PepperCat-YamanekoVillage/ESP32C3_USBSWITCHHUB/README.md

LICENSE -> https://creativecommons.org/licenses/by-nc-sa/4.0/
