PepperCat-YamanekoVillage/ESP32C3_USBSWITCHHUB/case/case.3mf

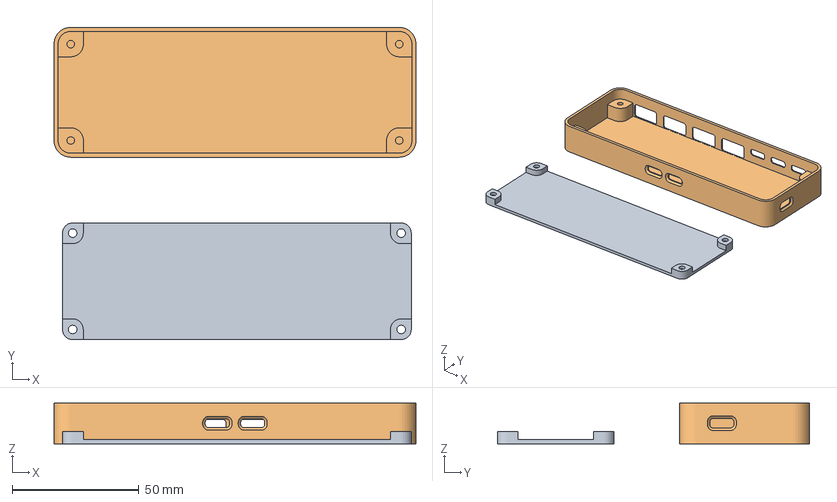
[picture p1: CAD file, 2025-08-16]
case/case.3mf
142.7 x 123.1 x 16.0 mm
lower.stl
upper.stl
