PepperCat-YamanekoVillage/ESP32C3_USBSWITCHHUB/case/upper.stl

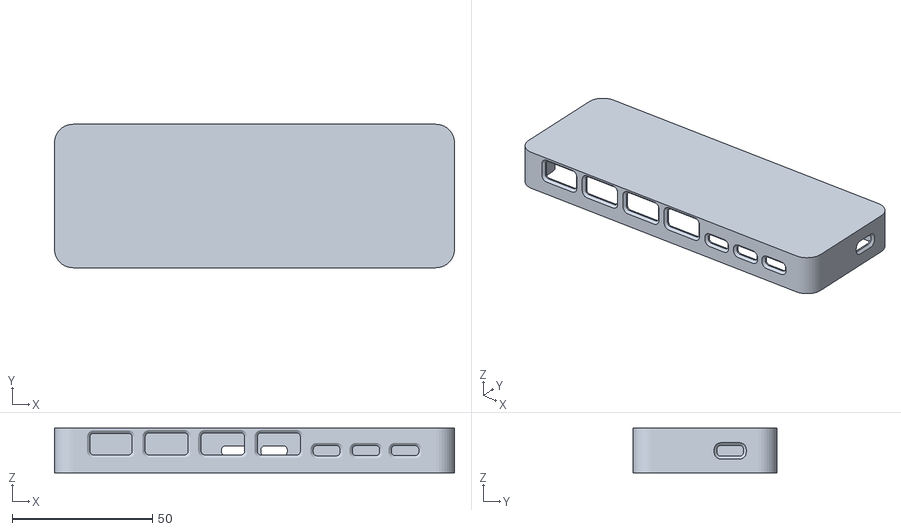
[picture p2: CAD file, 2025-08-16]
case/upper.stl
142.7 x 51.2 x 16.0
