PepperCat-YamanekoVillage/ESP32C3_USBSWITCHHUB/case/lower.stl

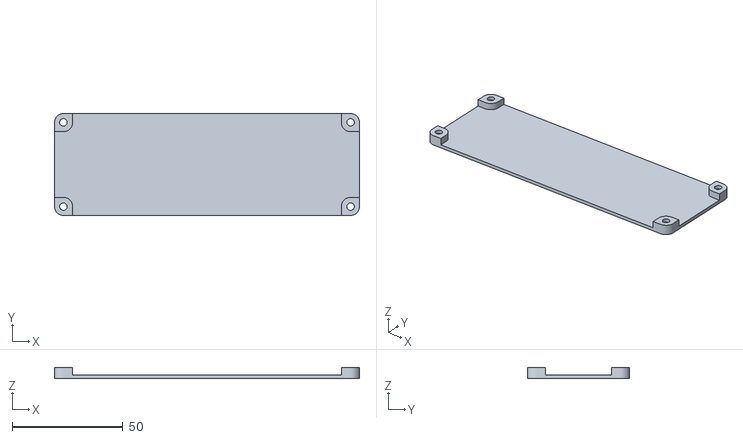
[picture p3: CAD file, 2025-08-16]
case/lower.stl
137.5 x 46.0 x 4.85
