PepperCat-YamanekoVillage/ESP32C3_USBSWITCHHUB/pcb/usbhub_rev.kicad_pcb

## KiCad design pcb/usbhub_rev.kicad_pcb (2025-08-16)

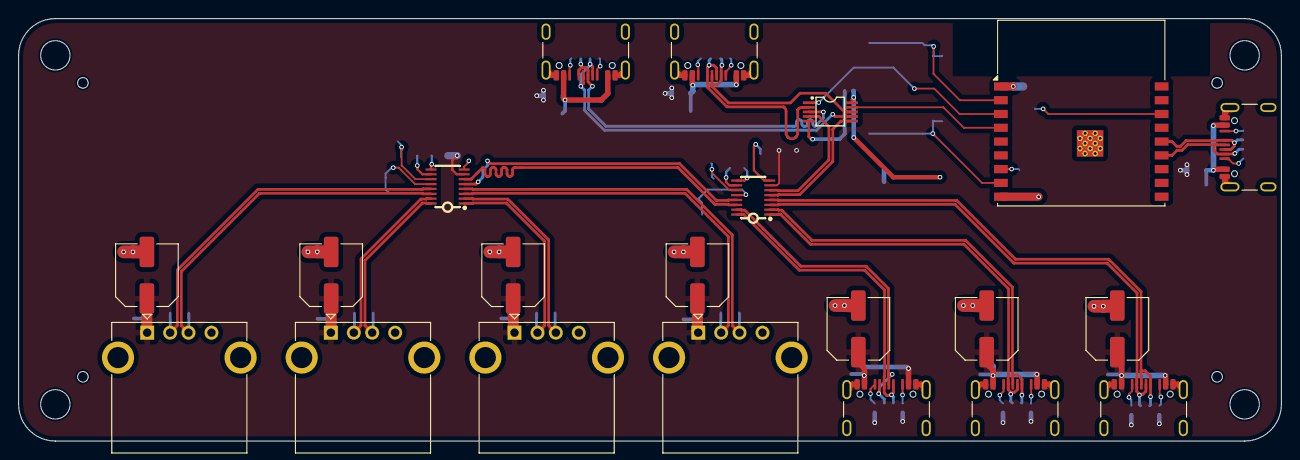
[picture p4: board usbhub_rev.kicad_pcb from above]

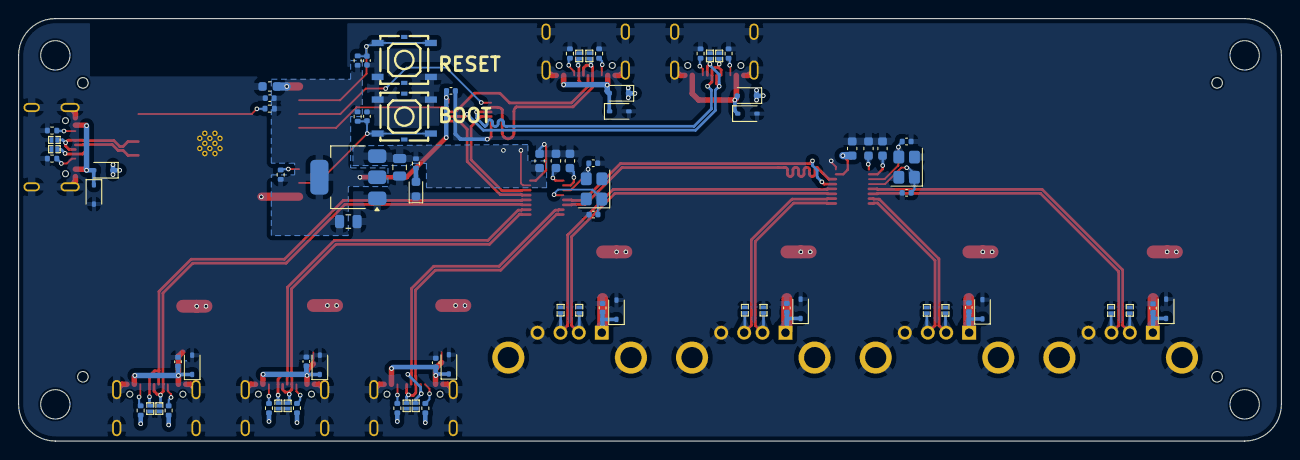
[picture p5: board usbhub_rev.kicad_pcb from below]

Board: 2 copper layers, 137.5 x 46.0 mm, 109 parts (80 on the bottom side), 57 nets.

Parts:
C1, C2, C7, C8, C9, C11, C12: 10uF; C_0603_1608Metric
C3, C17, C18, C20, C21, C23, C24: 100uF; C_Elec_6.3x5.4
C4, C19, C22, C25, C26, C27, C28, C29, C30, C31: 100nF; C_0402_1005Metric
C5, C6, C13, C15: 20pF; C_0402_1005Metric
C10, C14: 22uF; C_0805_2012Metric
C16: 12pF; C_0402_1005Metric
D1: LED; LED_0603_1608Metric
D2, D4, D5, D7, D8, D13, D14, D16, D17, D18, D20, D22, D23, D24, D26, D27, D29, D30, D32, D33: ESD/S3.3VmSp; DFN1006-2L_L1.0-W0.6-P0.60-BI
D3, D9, D11, D15, D19, D21, D25, D28, D31, D34: ESD/PW5V; D_SOD-323
D6, D10, D12: BAT/10V; D_SOD-323
H1, H2, H3, H4: MountingHole_3.2mm_M3_ISO7380
H5, H6, H7, H8: toolinghole
J1, J2, J3, J5, J6, J7: USB_C_Connecter; usbc_reflow
J4, J8, J9, J10: USB_A; USB_A_Kycon_KUSBX-AS1N-B_Horizontal
R1, R2, R23, R25: 10k; R_0402_1005Metric
R3, R4, R5, R6, R20, R21: 5.1k; R_0402_1005Metric
R7, R8, R9, R10, R11, R12: 56k; R_0402_1005Metric
R13: 2k; R_0402_1005Metric
SW2, SW3: SW_Push; SW-SMD_6P-L5.2-W5.2-P3.70-LS6.4
U1: ESP32-C3-WROOM-02
U2: TS3USB30EDGSR; VSSOP-10_L3.0-W3.0-P0.50-LS4.9-BL
U3, U5: SL2.1S; SSOP-16_L4.6-W2.6-P0.53-LS4.0-BL
U4: AMS1117-3.3; SOT-223-3_TabPin2
Y1, Y2: 12MHz; Crystal_SMD_3225-4Pin_3.2x2.5mm

Connections:
+3.3V: C1.2, C4.2, C14.1, C19.2, R1.1, R2.1, R23.2, R25.2, U1.1 (3V3), U2.10 (VCC), U4.2 (VO)
+5V: C2.1, C3.1, C7.1, C10.1, C17.1, C18.1, C20.1, C21.1, C23.1, C24.1, C25.2, C26.2, C27.2, C28.2, C29.2, C30.2, C31.2, D6.1 (K), D10.1 (K), D12.1 (K), D15.1 (A1), D19.1 (A1), D21.1 (A1), D25.1 (A1), D28.1 (A1), D31.1 (A1), D34.1 (A1), J4.1 (VBUS), J5.A4 (VBUS), J5.B9 (VBUS), J6.A4 (VBUS), J6.B9 (VBUS), J7.A4 (VBUS), J7.B9 (VBUS), J8.1 (VBUS), J9.1 (VBUS), J10.1 (VBUS), R7.2, R8.2, R9.2, R10.2, R11.2, R12.2, R13.1, U3.7 (VDD5), U4.3 (VI), U5.7 (VDD5)
/SELECT: U1.3 (IO4), U2.1 (S)
/deviceA1/D+: D26.2 (A2), J8.3 (D+), U5.2 (DP2)
/deviceA1/D-: D27.2 (A2), J8.2 (D-), U5.1 (DM2)
/deviceA2/D+: D29.2 (A2), J9.3 (D+), U5.16 (DP3)
/deviceA2/D-: D30.2 (A2), J9.2 (D-), U5.15 (DM3)
/deviceA3/D+: D32.2 (A2), J10.3 (D+), U5.14 (DP4)
/deviceA3/D-: D33.2 (A2), J10.2 (D-), U5.13 (DM4)
/deviceA/D+: D14.2 (A2), J4.3 (D+), U5.4 (DP1)
/deviceA/D-: D16.2 (A2), J4.2 (D-), U5.3 (DM1)
/deviceC1/D+: D17.2 (A2), J5.A6 (D+), J5.B6 (D+), U3.2 (DP2)
/deviceC1/D-: D18.2 (A2), J5.A7 (D-), J5.B7 (D-), U3.1 (DM2)
/deviceC2/D+: D22.2 (A2), J7.A6 (D+), J7.B6 (D+), U3.16 (DP3)
/deviceC2/D-: D24.2 (A2), J7.A7 (D-), J7.B7 (D-), U3.15 (DM3)
/deviceC/D+: D20.2 (A2), J6.A6 (D+), J6.B6 (D+), U3.4 (DP1)
/deviceC/D-: D23.2 (A2), J6.A7 (D-), J6.B7 (D-), U3.3 (DM1)
/esp32c3/BOOT: C16.2, R23.1, SW2.2, U1.8 (IO9)
/esp32c3/RESET: C22.2, R25.1, SW3.2, U1.2 (EN)
/esp32c3/USB_D+: D4.2 (A2), J1.A6 (D+), J1.B6 (D+), U1.14 (IO19)
/esp32c3/USB_D-: D5.2 (A2), J1.A7 (D-), J1.B7 (D-), U1.13 (IO18)
/host1/USB_D+: D8.2 (A2), J3.A6 (D+), J3.B6 (D+), U2.3 (D2+)
/host1/USB_D-: D13.2 (A2), J3.A7 (D-), J3.B7 (D-), U2.7 (D2-)
/host/USB_D+: D2.2 (A2), J2.A6 (D+), J2.B6 (D+), U2.2 (D1+)
/host/USB_D-: D7.2 (A2), J2.A7 (D-), J2.B7 (D-), U2.8 (D1-)
/hub/D+: U2.4 (D+), U3.6 (UDP)
/hub/D-: U2.6 (D-), U3.5 (UDM)
/hub/D_CHILD_D+: U3.14 (DP4), U5.6 (UDP)
/hub/D_CHILD_D-: U3.13 (DM4), U5.5 (UDM)
/~OE: U1.4 (IO5), U2.9 (~OE)
GND: C1.1, C2.2, C3.2, C4.1, C5.2, C6.1, C7.2, C8.1, C9.1, C10.2, C11.1, C12.1, C13.2, C14.2, C15.1, C16.1, C17.2, C18.2, C19.1, C20.2, C21.2, C22.1, C23.2, C24.2, C25.1, C26.1, C27.1, C28.1, C29.1, C30.1, C31.1, D1.1 (K), D2.1 (A1), D3.2 (A2), D4.1 (A1), D5.1 (A1), D7.1 (A1), D8.1 (A1), D9.2 (A2), D11.2 (A2), D13.1 (A1), D14.1 (A1), D15.2 (A2), D16.1 (A1), D17.1 (A1), D18.1 (A1), D19.2 (A2), D20.1 (A1), D21.2 (A2), D22.1 (A1), D23.1 (A1), D24.1 (A1), D25.2 (A2), D26.1 (A1), D27.1 (A1), D28.2 (A2), D29.1 (A1), D30.1 (A1), D31.2 (A2), D32.1 (A1), D33.1 (A1), D34.2 (A2), J1.A1 (GND), J1.S1 (SHIELD), J2.A1 (GND), J2.S1 (SHIELD), J3.A1 (GND), J3.S1 (SHIELD), J4.4 (GND), J4.5 (Shield), J5.A1 (GND), J5.S1 (SHIELD), J6.A1 (GND), J6.S1 (SHIELD), J7.A1 (GND), J7.S1 (SHIELD), J8.4 (GND), J8.5 (Shield), J9.4 (GND), J9.5 (Shield), J10.4 (GND), J10.5 (Shield), R3.2, R4.2, R5.2, R6.2, R20.2, R21.2, SW2.1, SW3.1, U1.9 (GND), U1.19 (GND), U2.5 (GND), U3.8 (VSS), U4.1 (GND), U5.8 (VSS), Y1.2, Y1.4, Y2.2, Y2.4
unnamed: D1.2 (A), R13.2
unnamed: D3.1 (A1), D6.2 (A), J2.A4 (VBUS), J2.B9 (VBUS)
unnamed: D9.1 (A1), D10.2 (A), J3.A4 (VBUS), J3.B9 (VBUS)
unnamed: D11.1 (A1), D12.2 (A), J1.A4 (VBUS), J1.B9 (VBUS)
unnamed: J1.A5 (CC1), R20.1
unnamed: J1.B5 (CC2), R21.1
unnamed: J2.A5 (CC1), R3.1
unnamed: J2.B5 (CC2), R4.1
unnamed: J3.A5 (CC1), R5.1
unnamed: J3.B5 (CC2), R6.1
unnamed: J5.A5 (CC1), R9.1
unnamed: J5.B5 (CC2), R10.1
unnamed: J6.A5 (CC1), R7.1
unnamed: J6.B5 (CC2), R8.1
unnamed: J7.A5 (CC1), R11.1
unnamed: J7.B5 (CC2), R12.1
unnamed: R1.2, U1.16 (IO2)
unnamed: R2.2, U1.7 (IO8)
unnamed: C8.2, U3.10 (VDD18)
unnamed: C9.2, U3.9 (VDD33)
unnamed: C5.1, U3.12 (XIN), Y1.1
unnamed: C6.2, U3.11 (XOUT), Y1.3
unnamed: C11.2, U5.10 (VDD18)
unnamed: C12.2, U5.9 (VDD33)
unnamed: C13.1, U5.12 (XIN), Y2.1
unnamed: C15.2, U5.11 (XOUT), Y2.3
